janek252/Day-Night-Roller/(commit log)

2024-05-30 JRPROJECT: added code for tmp sensor
2024-05-30 JRPROJECT: added code for i2c communication and two BH1750 SENSORS
2024-05-30 JRPROJECT: added code for i2c devices scanner
2024-06-01 JRPROJECT: added cmodified code for more sensors ode for i2c devices scanner
2024-06-01 JRPROJECT: added code with 5 sensors working on two i2c bus
2024-06-01 JRPROJECT: added code for motor and sensors working
